G-Horizon/fpga-neural-style-camera/hardware/photos/single_board_product.jpg

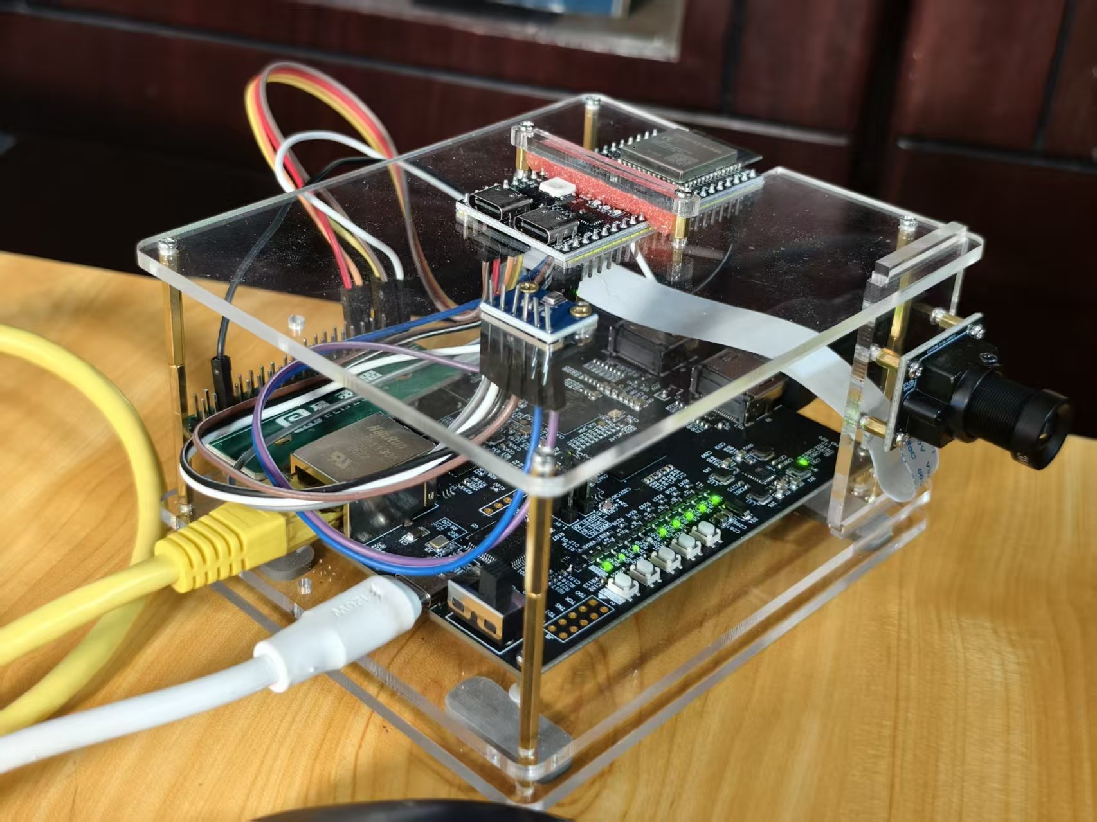
hardware/photos/single_board_product.jpg
