G-Horizon/fpga-neural-style-camera/docs/README.md

# 项目文档

本目录整理对外使用的系统说明与已测结果。

| 文档 | 内容 |
|---|---|
| [系统结构](system.md) | 单板与以太网双板链路、帧率含义、各板分工 |
| [模型与部署](model.md) | 模型结构、蒸馏、定点精度、共享计算、高清细节 |
| [使用与构建](build_and_use.md) | Efinity XML、ESP-IDF、手机网页与固件状态 |
| [接线说明](wiring.md) | 当前单板引脚、以太网双板连接、迁移外设的区别 |
| [手掌到握拳](gesture.md) | 空背景、动作规则、仿真与整机编译边界 |
| [性能与画质](performance/README.md) | 单板实测、双板已测项、量化效果 |
| [创新点与设计流程](design_process.md) | 从需求、训练、量化到硬件与集成验证 |
| [应用场景](applications.md) | 原型适用方向与实际落地条件 |
| [机械与加工资料](../hardware/README.md) | 自研亚克力平面图、参数、BOM与自有照片 |
