G-Horizon/fpga-neural-style-camera/models/teachers/README.md

# 三款教师权重

- vangogh_teacher.pth → student_d64_vangogh_affine
- ukiyoe_teacher.pth → student_d64_ukiyoe_affine
- inkwash_teacher.pth → student_d64_inkwash_affine
