G-Horizon/fpga-neural-style-camera/hardware/acrylic/dual_d2/hole_coordinates_mm.csv

part | hole | x_mm | y_mm | diameter_mm
DB01_Base | 1 | 5 | 5 | 2.4
DB01_Base | 2 | 5 | 95 | 2.4
DB01_Base | 3 | 115 | 95 | 2.4
DB01_Base | 4 | 115 | 15 | 2.4
DB02_Ti60_Carrier | 1 | 13 | 13 | 2.2
DB02_Ti60_Carrier | 2 | 13 | 48.814 | 2.2
DB02_Ti60_Carrier | 3 | 106.98 | 13 | 2.2
DB02_Ti60_Carrier | 4 | 106.98 | 87 | 2.2
DB02_Ti60_Carrier | 5 | 18.5 | 83 | 3.1
DB02_Ti60_Carrier | 6 | 48.5 | 83 | 3.1
DB02_Ti60_Carrier | 7 | 5 | 5 | 2.4
DB02_Ti60_Carrier | 8 | 5 | 95 | 2.4
DB02_Ti60_Carrier | 9 | 115 | 95 | 2.4
DB02_Ti60_Carrier | 10 | 115 | 15 | 2.4
DB02_Ti60_Carrier | 11 | 5 | 60 | 2.4
DB03_Optional_Top | 1 | 5 | 5 | 2.4
DB03_Optional_Top | 2 | 5 | 60 | 2.4
DB03_Optional_Top | 3 | 115 | 95 | 2.4
DB03_Optional_Top | 4 | 115 | 15 | 2.4
DB03_Optional_Top | 5 | 78 | 40 | 2.4
DB03_Optional_Top | 6 | 78 | 80 | 2.4
DB04_Optional_Camera | 1 | 4 | 22.5 | 2.2
DB04_Optional_Camera | 2 | 26 | 22.5 | 2.2
DB04_Optional_Camera | 3 | 4 | 37 | 2.2
DB04_Optional_Camera | 4 | 26 | 37 | 2.2
DB05_Optional_S3_Clamp | 1 | 0 | -20 | 2.4
DB05_Optional_S3_Clamp | 2 | 0 | 20 | 2.4
