G-Horizon/fpga-neural-style-camera/hardware/bom/dual_d4_30mm_mechanical_reference.csv

model_part_key | model_quantity | status_note
DB01_Base | 1 | D4 30mm complete CAD instance count; reference not actual purchased quantity
DB02_Ti60_Carrier | 2 | D4 30mm complete CAD instance count; reference not actual purchased quantity
FF_M2_L8_AF4 | 12 | D4 30mm complete CAD instance count; reference not actual purchased quantity
Nylon_M2_OD5_T0p5 | 98 | D4 30mm complete CAD instance count; reference not actual purchased quantity
Pan_M2x6 | 18 | D4 30mm complete CAD instance count; reference not actual purchased quantity
FF_M2_L30_D4 | 4 | D4 30mm complete CAD instance count; reference not actual purchased quantity
Stud_M2x12 | 7 | D4 30mm complete CAD instance count; reference not actual purchased quantity
Pan_M2x5 | 8 | D4 30mm complete CAD instance count; reference not actual purchased quantity
Foot_25x10x2_R2 | 4 | D4 30mm complete CAD instance count; reference not actual purchased quantity
FPGA_LIGHT | 2 | D4 30mm complete CAD instance count; reference not actual purchased quantity
DB04_Optional_Camera | 1 | D4 30mm complete CAD instance count; reference not actual purchased quantity
DB05_Optional_S3_Clamp | 1 | D4 30mm complete CAD instance count; reference not actual purchased quantity
S3 | 1 | D4 30mm complete CAD instance count; reference not actual purchased quantity
MIC | 1 | D4 30mm complete CAD instance count; reference not actual purchased quantity
Pan_M2x8 | 2 | D4 30mm complete CAD instance count; reference not actual purchased quantity
Nut_M2 | 8 | D4 30mm complete CAD instance count; reference not actual purchased quantity
Pan_M2x16 | 2 | D4 30mm complete CAD instance count; reference not actual purchased quantity
Silicone_pad_3x1p5_compressed2p4 | 1 | D4 30mm complete CAD instance count; reference not actual purchased quantity
Pan_M2x12 | 4 | D4 30mm complete CAD instance count; reference not actual purchased quantity
Nylon_camera_spacer_H3_OD4_ID2p2 | 4 | D4 30mm complete CAD instance count; reference not actual purchased quantity
DB03_Optional_Top | 1 | D4 30mm complete CAD instance count; reference not actual purchased quantity
FF_M2_L50_AF4 | 4 | D4 30mm complete CAD instance count; reference not actual purchased quantity
