G-Horizon/fpga-neural-style-camera/hardware/acrylic/dual_d2/DB04_Optional_Camera_1to1_mm.dxf

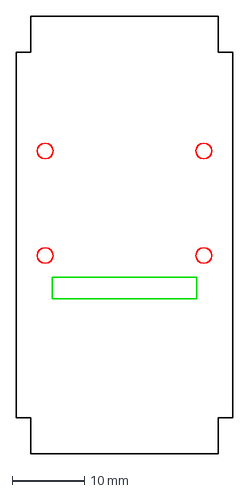
[picture p2: CAD file, 2026-11-03]
hardware/acrylic/dual_d2/DB04_Optional_Camera_1to1_mm.dxf
30.0 x 60.7 mm
