G-Horizon/fpga-neural-style-camera/hardware/acrylic/single_r2/02R2_camera_plate.dxf

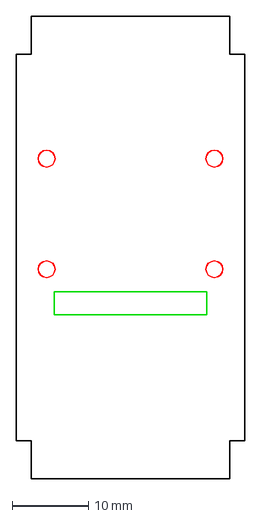
[picture p3: CAD file, 2026-11-03]
hardware/acrylic/single_r2/02R2_camera_plate.dxf
30.0 x 60.7 mm
