G-Horizon/fpga-neural-style-camera/hardware/acrylic/dual_d2/DB02_Ti60_Carrier_1to1_mm.dxf

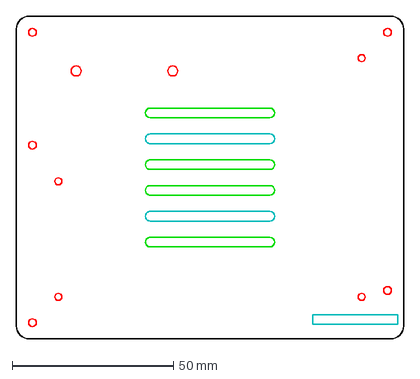
[picture p4: CAD file, 2026-11-03]
hardware/acrylic/dual_d2/DB02_Ti60_Carrier_1to1_mm.dxf
120.0 x 100.0 mm
