G-Horizon/fpga-neural-style-camera/hardware/acrylic/single_r2/05R2_s3_retainer.dxf

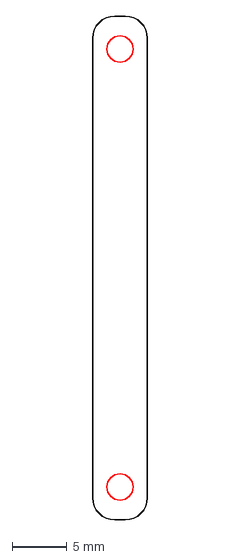
[picture p5: CAD file, 2026-11-03]
hardware/acrylic/single_r2/05R2_s3_retainer.dxf
5.00 x 46.0 mm
