G-Horizon/fpga-neural-style-camera/hardware/acrylic/dual_d2/DB05_Optional_S3_Clamp_1to1_mm.dxf

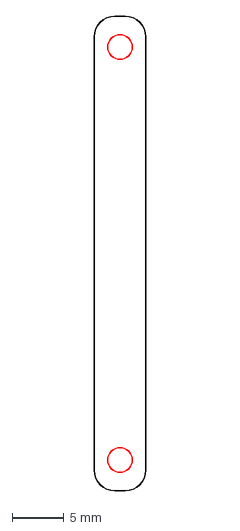
[picture p6: CAD file, 2026-11-03]
hardware/acrylic/dual_d2/DB05_Optional_S3_Clamp_1to1_mm.dxf
5.00 x 46.0 mm
