G-Horizon/fpga-neural-style-camera/hardware/acrylic/single_r2/01R2_mid_plate.dxf

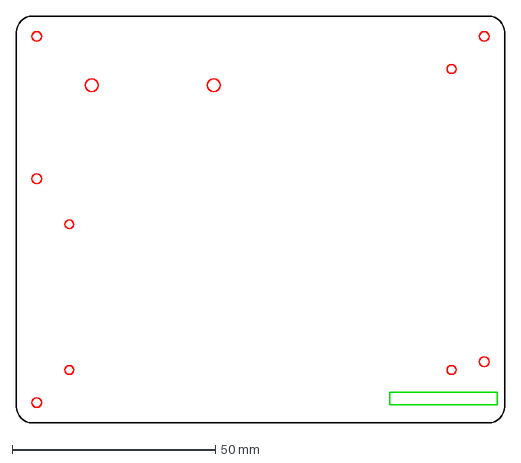
[picture p7: CAD file, 2026-11-03]
hardware/acrylic/single_r2/01R2_mid_plate.dxf
120.0 x 100.0 mm
