G-Horizon/fpga-neural-style-camera/hardware/acrylic/single_r2/04R2_upper_carrier.dxf

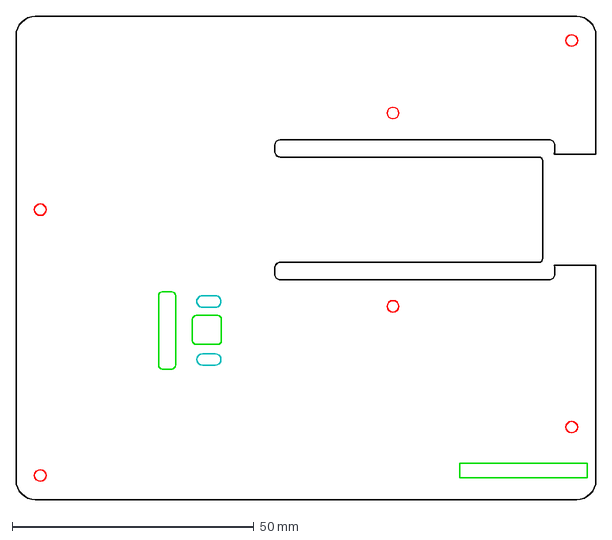
[picture p9: CAD file, 2026-11-03]
hardware/acrylic/single_r2/04R2_upper_carrier.dxf
120.0 x 100.0 mm
