G-Horizon/fpga-neural-style-camera/hardware/assembly_model/Ti60_Dual_Complete.SLDASM

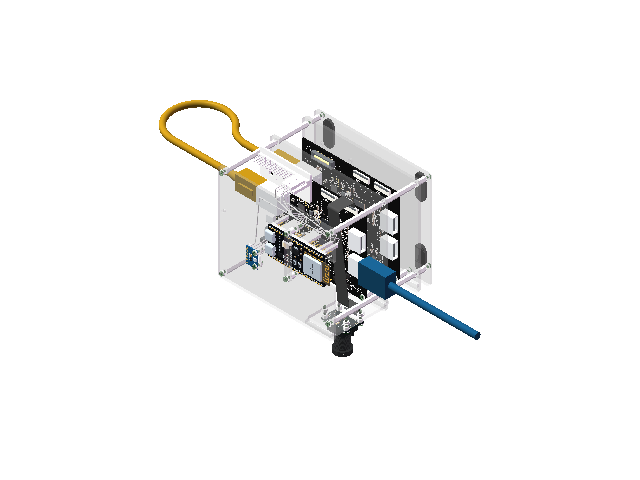
[picture p12: CAD file, 2026-11-03]
hardware/assembly_model/Ti60_Dual_Complete.SLDASM
DB01_Base_D2
DB02_Ti60_Carrier_D2 x 2
FF_M2_L8_AF4_D2 x 12
Nylon_M2_OD5_T0p5_D2 x 98
Pan_M2x6_D2 x 18
FF_M2_L30_D4 x 4
Stud_M2x12_D2 x 7
Pan_M2x5_D2 x 8
Adhesive_pad_25x10x2_R2 x 4
Ti60F225_holes_matched_to_measured_acrylic_R4_ASBUILT_R2 x 2
DB04_Optional_Camera_D2
DB05_Optional_S3_Clamp_D2
S3_R4_ASBUILT_R2
MIC_R4_ASBUILT_R2
Pan_M2x8_R4_ASBUILT_R2 x 2
Nut_M2_R4_ASBUILT_R2 x 8
Pan_M2x16_R4_ASBUILT_R2 x 2
Silicone_pad_3x1p5_compressed2p4_R4_ASBUILT_R2
Pan_M2x12_R4_ASBUILT_R2 x 4
Dupont_female_1x1_bored_R4_R4_ASBUILT_R2 x 18
Ribbon_signal_1_R5_ANIM_ASBUILT_R2
Ribbon_signal_2_R5_ANIM_ASBUILT_R2
Ribbon_signal_3_R5_ANIM_ASBUILT_R2
Ribbon_signal_4_R5_ANIM_ASBUILT_R2
Ribbon_signal_5_R5_ANIM_ASBUILT_R2
Mic_signal_1_R5_ANIM_ASBUILT_R2
Mic_signal_2_R5_ANIM_ASBUILT_R2
Mic_signal_3_R5_ANIM_ASBUILT_R2
Mic_signal_4_R5_ANIM_ASBUILT_R2
Common_GND_reference_R5_ANIM_ASBUILT_R2
Mic_3V3_reference_R5_ANIM_ASBUILT_R2
Mic_GND_reference_R5_ANIM_ASBUILT_R2
Camera_FPC_route_REFERENCE_R4_ASBUILT_R2
Camera_SC431HAI_6mm_PhotoReference_R4_ASBUILT_R2
Nylon_camera_spacer_H3_OD4_ID2p2_R4_ASBUILT_R2 x 4
EL001_J7_QTE_to_2x20_PhotoReference_R1_ASBUILT_R2
DB03_Optional_Top_D2
FF_M2_L50_AF4_D2 x 4
RJ45_Plug_Boot_REFERENCE_D3 x 2
Ethernet_Loop30_D4
HDMI_Display_Plug_REFERENCE_D3
HDMI_Display_Exit_OD6_L90_REFERENCE_D3
