G-Horizon/fpga-neural-style-camera/docs/build_and_use.md

# 使用与构建

### HDMI 显示

单板提供三种布局：

1. **全屏风格**：观看完整风格结果。
2. **并排对比**：左边完整原画、右边完整风格画，保持画面比例，上下留空。
3. **连续左右分屏**：左半显示原画对应位置，右半显示风格图对应位置，铺满 1920×1080，物体比例不变。

按风格键在梵高、浮世绘、水墨之间循环；另设帧率开关、布局切换和临时特效。具体键号、引脚和供电连接以所选工程配套接线说明为准。

三行数字分别表示：

| 屏幕文字 | 统计对象 |
|---|---|
| `CAM IN` | 合格的完整 256×144 摄像头输入帧成功入库速度，不仅统计帧起始信号 |
| `STYLE NEW` | 新风格结果进入显示的速度，重复显示旧帧不算新结果 |
| `HDMI SCAN` | HDMI 实际扫描刷新速度，单位 Hz |

### 手机观看与电脑遥控

ESP32-S3 使用 WROOM-1-N16R8 模组，通过 SPI 接收 FPGA 风格结果并建立本地热点，无需现场互联网或安装手机应用。

1. 按接线说明连接 FPGA、ESP32-S3 与麦克风，再给设备上电。
2. 手机或电脑连接演示热点 `Ti60-Style-Camera`，默认密码为 `ti60style`。
3. 手机 Chrome 打开 `http://192.168.4.1/`，竖屏观看白色主题页面。
4. 电脑打开 `http://192.168.4.1/debug`，进入遥控和状态页面。

手机接收 **256×144 风格图**，浏览器上采样为 **1280×720**。它没有再次运行 CNN，也没有采用 HDMI 端的原画细节融合，因此手机与 HDMI 的风格来源相同，但最终细节和接收帧率不同。

新单板KEY0轮换风格，KEY1开关三行帧率，KEY2切布局，KEY3触发特效。

### FPGA

1. 安装与工程对应的 **Efinity 2026.1**，准备 Ti60F225 板卡；
2. 各工程的 `profiles` 已包含配套三风格参数，保留原相对位置，并检查参数格式与所选固件版本匹配。
3. 单板在 Efinity 中打开 `final_camera_style.xml`；双板 A 打开 `d2e_board_a.xml`，双板 B 打开 **`d2e_board_b_full5.xml`**。它们位于对应方案的 `board/ddr3/` 目录。
4. 检查目标器件、引脚、时钟和模型文件引用，依次运行综合、布局布线、时序检查与 Bitstream 生成。
5. 通过 JTAG 下载 `.bit` 做临时运行。需要掉电保存时，使用配套 Flash 文件与烧录说明，同时写入所需模型区域。

`.bit` 编译通过、上板运行通过、Flash 写入通过和断电启动通过是不同的验收状态。

### ESP32-S3

白色页面固件使用 **ESP-IDF 6.0.1**。在已激活 ESP-IDF 环境的终端中，进入 `esp32/single/esp32/`：

```sh
idf.py -D SDKCONFIG=sdkconfig.mobile720-white menuconfig
idf.py -D SDKCONFIG=sdkconfig.mobile720-white build
idf.py -D SDKCONFIG=sdkconfig.mobile720-white -p PORT flash monitor
```

所附配置已选择 ESP32-S3。将 `PORT` 换成实际串口，在 `menuconfig` 中核对 16 MB Flash、DIO、80 MHz，以及热点、SPI、麦克风和语音选项。显式使用 `sdkconfig.mobile720-white`，并确认关闭 `STYLE_MOCK_SOURCE`：默认测试图不等于接收到真实 FPGA 画面。也可按 [ESP32 构建说明](../esp32/README.md)从仓库根目录使用配套构建脚本。

保留 `esp32/`、`mobile/`、`remote/` 的并列关系，构建会嵌入两套网页。只复制 ESP32 主程序而遗漏网页目录，会导致资源不完整。

### 重新训练模型

训练与定点导出属于离线步骤：准备内容与风格素材，训练教师，冻结教师训练学生，再折叠固定变换、校准和导出三套参数。具体环境、数据来源和命令以 `training/` 配套说明为准。改动网络通道、量化格式或参数布局后，需要同步调整 RTL 与整数参考，不能直接替换权重文件。

## 启动

- 当前单板正式固件为 `single_board_palm_to_fist.bit`。
