G-Horizon/fpga-neural-style-camera/docs/performance/README.md

# 已测性能与数值验证

## 1. 延迟结果

| 指标 | 单板 | 双板 |
|---|---|---|
| 整网推理延迟 | 平均 15.446 ms | - |
| 摄像头到屏幕可见响应 | 平均 100.9 ms | 平均 85.3 ms |
| 风格切换延迟 | 平均 47.750 ms | - |

光学延迟来自约 239.76 fps 录像，比较同一方格达到新旧亮度中点的时间，采样间隔约 4.171 ms；对应梵高风格、单板 30 帧和双板 60 帧的指定测试场景。切换延迟从控制器接受命令计时，到新风格首个有效像素进入显示链，不含按键去抖和液晶实际出光时间。

## 2. 单板实测三风格画质与量化误差

| 风格 | 每图PSNR平均 dB | 平均SSIM |
| --- | ---: | ---: |
| 梵高 | 37.8337 | 0.981044 |
| 浮世绘 | 43.3100 | 0.994728 |
| 水墨 | 44.3717 | 0.996078 |

## 单板方案编译指标

| 指标 | 编译结果 |
|---|---:|
| XLR | 60,711/60,800 |
| BRAM | 256/256 |
| DSP | 159/160 |
| setup余量 | +0.003ns |
| hold余量 | +0.010ns |
