G-Horizon/fpga-neural-style-camera/docs/performance/fixed24_integer_vs_fp32.csv

style | name | dataset | comparison | psnr_db | ssim_rgb | mae_levels | mse_levels2 | rmse_levels | max_abs_levels | exact_fraction | abs_gt1_fraction | p99_abs_levels
vangogh | val_000000477805 | fixed_val_16x9 | integer_vs_fp32_u8 | 41.375482139306456 | 0.9886611487192521 | 1.7287416811342593 | 4.73731372974537 | 2.1765370958808328 | 10.0 | 0.1943359375 | 0.5126862702546297 | 5.0
vangogh | val_000000122745 | fixed_val_16x9 | integer_vs_fp32_u8 | 42.01960712751918 | 0.987695183169683 | 1.5023781105324074 | 4.084318938078703 | 2.020969801377226 | 20.0 | 0.23069480613425927 | 0.41721824363425924 | 6.0
vangogh | val_000000289229 | fixed_val_16x9 | integer_vs_fp32_u8 | 32.109141572526866 | 0.9677555097161484 | 3.9995478877314814 | 40.00978370949074 | 6.325328743195151 | 55.0 | 0.13207103587962962 | 0.6459237557870371 | 24.0
vangogh | val_000000496409 | fixed_val_16x9 | integer_vs_fp32_u8 | 25.815082243098402 | 0.9309978561527475 | 8.311821831597221 | 170.44023980034723 | 13.055276320336818 | 113.0 | 0.07020399305555555 | 0.8035210503472222 | 49.0
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
