G-Horizon/fpga-neural-style-camera/fpga/single/board/ddr3/final_camera_style_top.v

`timescale 1ns/1ps
// Physical camera-only root. No simulated IP is in the hardware file list.
module final_camera_style_top #(
    // Staging default for the physically inverted camera. CFA3 is the
    // pure-reversal expectation; actual sensor colour phase remains to verify.
    parameter integer CAM_ROTATE_180=1,
    parameter [1:0] CAM_CFA=(CAM_ROTATE_180!=0 ? 2'd3 : 2'd0),
    parameter [15:0] CAM_WB_R_Q8=519,
    parameter [15:0] CAM_WB_G_Q8=256,
    parameter [15:0] CAM_WB_B_Q8=427,
    parameter integer CAM_GAMMA_EN=1,
    parameter integer DISPLAY_SCALE=5,
    parameter integer DISPLAY_BILINEAR=1, DISPLAY_DST_W=1920, DISPLAY_DST_H=1080,
    parameter integer CAM_PACKED=0, GUIDE_ENABLE=1, COMPACT_UART=1, STATUS_UART_ENABLE=0,
    parameter integer FPS_OSD_ENABLE=1, FPS_DEFAULT_ON=1,
    parameter integer VOICE_ENABLE=0,GESTURE_ENABLE=1,COMPARISON_ENABLE=1,PREVIEW_ENABLE=1,REMOTE_DEBUG_ENABLE=1
) (
    input wire clk_25m,
    input wire clk_weight_fast,
    input wire pll_lock,
    input wire pll1_lock,
    output wire ddr_pll_rstn,
    output wire sys_pll_rstn,
    input wire hdmi_tx_slow_clk,
    input wire hdmi_tx_fast_clk,
    input wire clk,
    input wire ddr_core_clk,
    input wire ddr_twd_clk,
    input wire ddr_tac_clk,
    input wire ddr_tdqss_clk,
    output wire ddr_reset,
    output wire ddr_cs,
    output wire ddr_ras,
    output wire ddr_cas,
    output wire ddr_we,
    output wire ddr_cke,
    output wire [15:0] ddr_addr,
    output wire [2:0] ddr_ba,
    output wire ddr_odt,
    output wire [1:0] o_ddr_dm_hi,
    output wire [1:0] o_ddr_dm_lo,
    input wire [1:0] i_ddr_dqs_hi,
    input wire [1:0] i_ddr_dqs_lo,
    input wire [1:0] i_ddr_dqs_n_hi,
    input wire [1:0] i_ddr_dqs_n_lo,
    output wire [1:0] o_ddr_dqs_hi,
    output wire [1:0] o_ddr_dqs_lo,
    output wire [1:0] o_ddr_dqs_oe,
    output wire [1:0] o_ddr_dqs_n_oe,
    input wire [15:0] i_ddr_dq_hi,
    input wire [15:0] i_ddr_dq_lo,
    output wire [15:0] o_ddr_dq_hi,
    output wire [15:0] o_ddr_dq_lo,
    output wire [15:0] o_ddr_dq_oe,
    output wire [2:0] ddr_shift,
    output wire [4:0] ddr_shift_sel,
    output wire ddr_shift_ena,
    input wire verf0,
    input wire verf1,
    output wire [9:0] tmds_data0_o,
    output wire [9:0] tmds_data1_o,
    output wire [9:0] tmds_data2_o,
    output wire [9:0] tmds_clk_o,
    output wire tmds_data0_TX_OE,
    output wire tmds_data1_TX_OE,
    output wire tmds_data2_TX_OE,
    output wire tmds_clk_TX_OE,
    output wire tmds_data0_TX_RST,
    output wire tmds_data1_TX_RST,
    output wire tmds_data2_TX_RST,
    output wire tmds_clk_TX_RST,
    output wire [3:0] led,
    output wire txd,
    output wire HPD_N,
    input wire [3:0] keys_n,
    input wire spi_preview_sclk,spi_preview_cs_n,spi_preview_mosi,
    output wire spi_preview_miso,spi_preview_ready,
    input wire [3:0] i_spi0_io,
    output wire [3:0] o_spi0_io,
    output wire [3:0] oe_spi0_io,
    output wire o_spi_clk,
    output wire oe_spi_clk,
    output wire o_spi0_cs,
    output wire oe_spi0_cs,
    input wire io_cam_scl_IN,
    input wire io_cam_sda_IN,
    input wire i_cam_ck_CLKOUT,
    input wire i_cam_ck_LP_N_IN,
    input wire i_cam_ck_LP_P_IN,
    input wire cam_d2_FIFO_EMPTY,
    input wire [7:0] cam_d2_HS_IN,
    input wire cam_d2_LP_N_IN,
    input wire cam_d2_LP_P_IN,
    input wire cam_d3_FIFO_EMPTY,
    input wire [7:0] cam_d3_HS_IN,
    input wire cam_d3_LP_N_IN,
    input wire cam_d3_LP_P_IN,
    input wire cam_d0_FIFO_EMPTY,
    input wire [7:0] cam_d0_HS_IN,
    input wire cam_d0_LP_N_IN,
    input wire cam_d0_LP_P_IN,
    input wire cam_d1_FIFO_EMPTY,
    input wire [7:0] cam_d1_HS_IN,
    input wire cam_d1_LP_N_IN,
    input wire cam_d1_LP_P_IN,
    output wire io_cam_scl_OUT,
    output wire io_cam_scl_OE,
    output wire io_cam_sda_OUT,
    output wire io_cam_sda_OE,
    output wire o_cam_rst_p,
    output wire o_cam_ck_HS_ENA,
    output wire o_cam_ck_HS_TERM,
    output wire cam_d2_FIFO_RD,
    output wire cam_d2_HS_ENA,
    output wire cam_d2_HS_TERM,
    output wire cam_d2_RST,
    output wire cam_d3_FIFO_RD,
    output wire cam_d3_HS_ENA,
    output wire cam_d3_HS_TERM,
    output wire cam_d3_RST,
    output wire cam_d0_FIFO_RD,
    output wire cam_d0_HS_ENA,
    output wire cam_d0_HS_TERM,
    output wire cam_d0_RST,
    output wire cam_d1_FIFO_RD,
    output wire cam_d1_HS_ENA,
    output wire cam_d1_HS_TERM,
    output wire cam_d1_RST,
    input wire sys_clk_50mhz,
    input wire hdmi_tx_locked
);
    wire camera_reset_n=pll_lock&&pll1_lock;
    wire camera_accepting;
    wire rx_pix_valid_o;
    wire [63:0] rx_pix_data_o;
    wire [3:0] rx_pix_per_clk_o;
    wire rx_hsync_o;
    wire rx_vsync_o;
    wire rst_pix_n_o;
    wire config_done;
    wire config_error;
    wire [31:0] sensor_readback;
    wire [7:0] sensor_orientation_readback; // optional future UART observation
    wire [5:0] rx_datatype_o;
    wire rx_irq_o;
    wire [15:0] rx_word_count_o;
    wire [15:0] rx_shortpkt_o;
    wire [1:0] rx_vc_o;
    wire raw_valid,raw_sof,raw_sol,raw_eol,raw_eof;
    wire[9:0] raw10;wire[31:0] raw_frame_id;
    wire raw_overflow,raw_ppc_bad;
    wire packed_valid,packed_sof,packed_sol,packed_eol,packed_eof;
    wire [39:0] packed_raw4;
    wire [31:0] packed_fid;
    wire packed_bad;
    d64_camera_frontend_517 #(.ROTATE_180(CAM_ROTATE_180)) u_camera(
        .i_arstn(camera_reset_n),
        .CLK_25M(clk_25m),
        .core_clk(clk),
        .i_mipi_rx_pclk(sys_clk_50mhz),
        .io_cam_scl_IN(io_cam_scl_IN),
        .io_cam_sda_IN(io_cam_sda_IN),
        .i_cam_ck_CLKOUT(i_cam_ck_CLKOUT),
        .i_cam_ck_LP_N_IN(i_cam_ck_LP_N_IN),
        .i_cam_ck_LP_P_IN(i_cam_ck_LP_P_IN),
        .cam_d2_FIFO_EMPTY(cam_d2_FIFO_EMPTY),
        .cam_d2_HS_IN(cam_d2_HS_IN),
        .cam_d2_LP_N_IN(cam_d2_LP_N_IN),
        .cam_d2_LP_P_IN(cam_d2_LP_P_IN),
        .cam_d3_FIFO_EMPTY(cam_d3_FIFO_EMPTY),
        .cam_d3_HS_IN(cam_d3_HS_IN),
        .cam_d3_LP_N_IN(cam_d3_LP_N_IN),
        .cam_d3_LP_P_IN(cam_d3_LP_P_IN),
        .cam_d0_FIFO_EMPTY(cam_d0_FIFO_EMPTY),
        .cam_d0_HS_IN(cam_d0_HS_IN),
        .cam_d0_LP_N_IN(cam_d0_LP_N_IN),
        .cam_d0_LP_P_IN(cam_d0_LP_P_IN),
        .cam_d1_FIFO_EMPTY(cam_d1_FIFO_EMPTY),
        .cam_d1_HS_IN(cam_d1_HS_IN),
        .cam_d1_LP_N_IN(cam_d1_LP_N_IN),
        .cam_d1_LP_P_IN(cam_d1_LP_P_IN),
        .io_cam_scl_OUT(io_cam_scl_OUT),
        .io_cam_scl_OE(io_cam_scl_OE),
        .io_cam_sda_OUT(io_cam_sda_OUT),
        .io_cam_sda_OE(io_cam_sda_OE),
        .o_cam_rst_p(o_cam_rst_p),
        .o_cam_ck_HS_ENA(o_cam_ck_HS_ENA),
        .o_cam_ck_HS_TERM(o_cam_ck_HS_TERM),
        .cam_d2_FIFO_RD(cam_d2_FIFO_RD),
        .cam_d2_HS_ENA(cam_d2_HS_ENA),
        .cam_d2_HS_TERM(cam_d2_HS_TERM),
        .cam_d2_RST(cam_d2_RST),
        .cam_d3_FIFO_RD(cam_d3_FIFO_RD),
        .cam_d3_HS_ENA(cam_d3_HS_ENA),
        .cam_d3_HS_TERM(cam_d3_HS_TERM),
        .cam_d3_RST(cam_d3_RST),
        .cam_d0_FIFO_RD(cam_d0_FIFO_RD),
        .cam_d0_HS_ENA(cam_d0_HS_ENA),
        .cam_d0_HS_TERM(cam_d0_HS_TERM),
        .cam_d0_RST(cam_d0_RST),
        .cam_d1_FIFO_RD(cam_d1_FIFO_RD),
        .cam_d1_HS_ENA(cam_d1_HS_ENA),
        .cam_d1_HS_TERM(cam_d1_HS_TERM),
        .cam_d1_RST(cam_d1_RST),
        .rx_pix_valid_o(rx_pix_valid_o),
        .rx_pix_data_o(rx_pix_data_o),
        .rx_pix_per_clk_o(rx_pix_per_clk_o),
        .rx_hsync_o(rx_hsync_o),
        .rx_vsync_o(rx_vsync_o),
        .rst_pix_n_o(rst_pix_n_o),
        .config_done(config_done),
        .config_error(config_error),
        .sensor_readback(sensor_readback),
        .sensor_orientation_readback(sensor_orientation_readback),
        .rx_datatype_o(rx_datatype_o),
        .rx_irq_o(rx_irq_o),
        .rx_word_count_o(rx_word_count_o),
        .rx_shortpkt_o(rx_shortpkt_o),
        .rx_vc_o(rx_vc_o)
    );
    generate if(CAM_PACKED==0)begin:g_scalar_raw
    assign packed_valid=0;assign packed_raw4=0;assign packed_sof=0;
    assign packed_sol=0;assign packed_eol=0;assign packed_eof=0;assign packed_fid=0;assign packed_bad=0;
    d64_csi2_raw_to_contract_a #(.AW(9),.PPC_MAX(4),.W_SRC(1920),.H_SRC(1080)) u_raw(
        .clk_pix(sys_clk_50mhz),
        .rst_pix_n(rst_pix_n_o),
        .pix_valid(rx_pix_valid_o),
        .pix_data(rx_pix_data_o),
        .pix_per_clk(rx_pix_per_clk_o),
        .hsync(rx_hsync_o),
        .vsync(rx_vsync_o),
        .clk_a(clk),
        .rst_a_n(camera_reset_n),
        .raw_valid(raw_valid),
        .raw10(raw10),
        .raw_sof(raw_sof),
        .raw_sol(raw_sol),
        .raw_eol(raw_eol),
        .raw_eof(raw_eof),
        .raw_frame_id(raw_frame_id),
        .beats_in(),
        .px_in(),
        .beats_out(),
        .px_out(),
        .frames_out(),
        .overflow(raw_overflow),
        .ppc_bad(raw_ppc_bad)
    );
    end else begin:g_packed_raw
        wire native_bad;
        assign raw_valid=0;assign raw10=0;assign raw_sof=0;assign raw_sol=0;
        assign raw_eol=0;assign raw_eof=0;assign raw_frame_id=0;
        (* async_reg="true" *) reg [1:0] packed_bad_sync;
        always @(posedge clk or negedge camera_reset_n)
            if(!camera_reset_n)packed_bad_sync<=0;
            else packed_bad_sync<={packed_bad_sync[0],native_bad};
        assign raw_overflow=packed_bad_sync[1];assign raw_ppc_bad=packed_bad_sync[1];
        assign packed_bad=native_bad;
        d64_packed_raw_camera_adapter u_adapter(
            .clk_pix(sys_clk_50mhz),.rst_pix_n(rst_pix_n_o),
            .pix_valid(rx_pix_valid_o),.pix_data(rx_pix_data_o),.pix_per_clk(rx_pix_per_clk_o),
            .vsync(rx_vsync_o),.raw_valid(packed_valid),.raw4(packed_raw4),
            .raw_sof(packed_sof),.raw_sol(packed_sol),.raw_eol(packed_eol),.raw_eof(packed_eof),
            .raw_frame_id(packed_fid),.beats_in(),.packing_errors(),.incomplete_frames(),
            .source_bad_sticky(native_bad));
    end endgenerate
    (* async_reg="true" *) reg [1:0] capture_allow_pix;
    reg packed_capture_enabled;
    always @(posedge sys_clk_50mhz or negedge rst_pix_n_o)begin
        if(!rst_pix_n_o)begin capture_allow_pix<=0;packed_capture_enabled<=0;end
        else begin
            capture_allow_pix<={capture_allow_pix[0],config_done&&!config_error&&camera_accepting};
            if(packed_valid&&packed_sof&&capture_allow_pix[1])packed_capture_enabled<=1;
        end
    end
    reg capture_enabled=0;
    always @(posedge clk or negedge camera_reset_n) begin
        if(!camera_reset_n)capture_enabled<=0;
        else if(raw_sof&&config_done&&!config_error&&camera_accepting)capture_enabled<=1;
    end
    d64_final_system #(.CAM_CFA(CAM_CFA),
        .CAM_PACKED(CAM_PACKED),.GUIDE_ENABLE(GUIDE_ENABLE),.COMPACT_UART(COMPACT_UART),
        .CAM_WB_R_Q8(CAM_WB_R_Q8), .CAM_WB_G_Q8(CAM_WB_G_Q8),
        .CAM_WB_B_Q8(CAM_WB_B_Q8), .CAM_GAMMA_EN(CAM_GAMMA_EN),.DISPLAY_SCALE(DISPLAY_SCALE),
        .DISPLAY_BILINEAR(DISPLAY_BILINEAR),.DISPLAY_DST_W(DISPLAY_DST_W),.DISPLAY_DST_H(DISPLAY_DST_H),
        .H_ACT(1920),.H_FP(88),.H_SYNC(44),.H_BP(148),
        .V_ACT(1080),.V_FP(4),.V_SYNC(5),.V_BP(36),
        .FPS_OSD_ENABLE(FPS_OSD_ENABLE),.FPS_DEFAULT_ON(FPS_DEFAULT_ON),
        .STATUS_UART_ENABLE(STATUS_UART_ENABLE),.VOICE_ENABLE(VOICE_ENABLE),.GESTURE_ENABLE(GESTURE_ENABLE),.COMPARISON_ENABLE(COMPARISON_ENABLE),.PREVIEW_ENABLE(PREVIEW_ENABLE),.REMOTE_DEBUG_ENABLE(REMOTE_DEBUG_ENABLE)) u_system(
        .clk_25m(clk_25m),
        .pll_lock(pll_lock),
        .pll1_lock(pll1_lock),
        .pe_pll_lock(hdmi_tx_locked),
        .ddr_pll_rstn(ddr_pll_rstn),
        .sys_pll_rstn(sys_pll_rstn),
        .pe_pll_rstn(),
        .clk_pe(clk),
        .clk_weight_fast(clk_weight_fast),
        .hdmi_tx_slow_clk(hdmi_tx_slow_clk),
        .hdmi_tx_fast_clk(hdmi_tx_fast_clk),
        .clk(clk),
        .ddr_core_clk(ddr_core_clk),
        .ddr_twd_clk(ddr_twd_clk),
        .ddr_tac_clk(ddr_tac_clk),
        .ddr_tdqss_clk(ddr_tdqss_clk),
        .ddr_reset(ddr_reset),
        .ddr_cs(ddr_cs),
        .ddr_ras(ddr_ras),
        .ddr_cas(ddr_cas),
        .ddr_we(ddr_we),
        .ddr_cke(ddr_cke),
        .ddr_addr(ddr_addr),
        .ddr_ba(ddr_ba),
        .ddr_odt(ddr_odt),
        .o_ddr_dm_hi(o_ddr_dm_hi),
        .o_ddr_dm_lo(o_ddr_dm_lo),
        .i_ddr_dqs_hi(i_ddr_dqs_hi),
        .i_ddr_dqs_lo(i_ddr_dqs_lo),
        .i_ddr_dqs_n_hi(i_ddr_dqs_n_hi),
        .i_ddr_dqs_n_lo(i_ddr_dqs_n_lo),
        .o_ddr_dqs_hi(o_ddr_dqs_hi),
        .o_ddr_dqs_lo(o_ddr_dqs_lo),
        .o_ddr_dqs_n_hi(),
        .o_ddr_dqs_n_lo(),
        .o_ddr_dqs_oe(o_ddr_dqs_oe),
        .o_ddr_dqs_n_oe(o_ddr_dqs_n_oe),
        .i_ddr_dq_hi(i_ddr_dq_hi),
        .i_ddr_dq_lo(i_ddr_dq_lo),
        .o_ddr_dq_hi(o_ddr_dq_hi),
        .o_ddr_dq_lo(o_ddr_dq_lo),
        .o_ddr_dq_oe(o_ddr_dq_oe),
        .ddr_shift(ddr_shift),
        .ddr_shift_sel(ddr_shift_sel),
        .ddr_shift_ena(ddr_shift_ena),
        .verf0(verf0),
        .verf1(verf1),
        .cam_raw_valid(raw_valid&&(capture_enabled||raw_sof)&&config_done&&!config_error&&camera_accepting),
        .cam_raw10(raw10),
        .cam_sof(raw_sof),
        .cam_sol(raw_sol),
        .cam_eol(raw_eol),
        .cam_eof(raw_eof),
        .cam_frame_id(raw_frame_id),
        .cam_packed_clk(sys_clk_50mhz),.cam_packed_rst_n(rst_pix_n_o),
        .cam_packed_valid(packed_valid&&(packed_capture_enabled||packed_sof)&&capture_allow_pix[1]),
        .cam_packed_raw4(packed_raw4),.cam_packed_sof(packed_sof),.cam_packed_sol(packed_sol),
        .cam_packed_eol(packed_eol),.cam_packed_eof(packed_eof),.cam_packed_fid(packed_fid),
        .cam_packed_source_bad(packed_bad),
        .io_cam_scl_IN(1'b1),
        .io_cam_sda_IN(1'b1),
        .io_cam_scl_OUT(),
        .io_cam_scl_OE(),
        .io_cam_sda_OUT(),
        .io_cam_sda_OE(),
        .o_cam_rst_p(),
        .tmds_data0_o(tmds_data0_o),
        .tmds_data1_o(tmds_data1_o),
        .tmds_data2_o(tmds_data2_o),
        .tmds_clk_o(tmds_clk_o),
        .tmds_data0_TX_OE(tmds_data0_TX_OE),
        .tmds_data1_TX_OE(tmds_data1_TX_OE),
        .tmds_data2_TX_OE(tmds_data2_TX_OE),
        .tmds_clk_TX_OE(tmds_clk_TX_OE),
        .tmds_data0_TX_RST(tmds_data0_TX_RST),
        .tmds_data1_TX_RST(tmds_data1_TX_RST),
        .tmds_data2_TX_RST(tmds_data2_TX_RST),
        .tmds_clk_TX_RST(tmds_clk_TX_RST),
        .led(led),
        .txd(txd),
        .HPD_N(HPD_N),
        .keys_n(keys_n),
        .spi_preview_sclk(spi_preview_sclk),.spi_preview_cs_n(spi_preview_cs_n),.spi_preview_mosi(spi_preview_mosi),
        .spi_preview_miso(spi_preview_miso),.spi_preview_ready(spi_preview_ready),
        .camera_status({3'd0,rx_word_count_o,rx_vc_o,rx_datatype_o,rx_irq_o,raw_ppc_bad,raw_overflow,config_error,config_done}),
        .camera_readback(sensor_readback),
        .camera_accepting(camera_accepting),
        .i_spi0_io(i_spi0_io),
        .o_spi0_io(o_spi0_io),
        .oe_spi0_io(oe_spi0_io),
        .o_spi_clk(o_spi_clk),
        .oe_spi_clk(oe_spi_clk),
        .o_spi0_cs(o_spi0_cs),
        .oe_spi0_cs(oe_spi0_cs)
    );
endmodule
