G-Horizon/fpga-neural-style-camera/fpga/dual/board_a/rtl/d2e_a_slots_fast3.v

`timescale 1ns/1ps
// Eight native guides stay leased from camera commit through remote compute
// and display retirement. All ports below belong to the application clock.
module d2e_a_slots(
 input wire clk,rst_n,session_valid,input wire[31:0]local_session,remote_session,
 input wire capture_commit,input wire[2:0]capture_slot,input wire[31:0]capture_fid,
 output reg release_valid,output reg[2:0]release_slot,output wire[7:0]owned_mask,
 input wire[1:0]ui_style,input wire ui_fps,input wire[7:0]ui_effect,input wire[31:0]ui_epoch,
 input wire compute_ready,compute_done,compute_fault,output reg compute_start,
 output reg[2:0]compute_slot,output wire[1:0]compute_profile,output wire[31:0]compute_fid,
 output wire tx_job_valid,input wire tx_job_ready,output wire[31:0]tx_base,tx_fid,tx_epoch,
 output wire[1:0]tx_style,tx_layout,output wire tx_fps,output wire[7:0]tx_effect,
 input wire tx_done,tx_done_ok,input wire[31:0]tx_done_fid,
 input wire allocate_valid,output wire allocate_ready,allocate_ok,output wire[31:0]allocate_base,
 input wire[31:0]allocate_fid,allocate_epoch,input wire[1:0]allocate_style,allocate_layout,
 input wire allocate_fps,input wire[7:0]allocate_effect,
 input wire commit_valid,commit_cancel,output wire commit_ready,
 input wire[31:0]commit_base,commit_fid,commit_epoch,input wire[1:0]commit_style,commit_layout,
 input wire commit_fps,input wire[7:0]commit_effect,
 input wire abort_valid,input wire[31:0]abort_base,abort_fid,
 output reg publish_valid,input wire publish_ready,output wire[31:0]publish_base,publish_fid,publish_epoch,
 output wire[2:0]publish_slot,output wire publish_fps,
 input wire active_valid,input wire[31:0]active_fid,active_epoch,active_base,
 input wire[7:0]reader_protect_mask,
 output reg fault,output reg[31:0]computed_frames,returned_frames,published_frames,retired_frames,discarded_frames
);
 localparam FREE=0,CAPTURED=1,COMPUTING=2,COMPUTED=3,WAITING=4,RESULT=5,PENDING=6,DISPLAY=7,RETIRING=8;
 reg[3:0]state[0:7];reg[31:0]fid[0:7],epoch[0:7];
 reg[1:0]style[0:7];reg fps[0:7];reg[7:0]effect[0:7];
 reg[7:0]stale,rx_lease,feature_acked;reg[3:0]retire_guard[0:7];
 reg compute_busy,tx_busy,publish_busy,tx_offer_valid;reg[2:0]tx_slot,pub_slot;
 reg previous_session_valid;reg[31:0]previous_local,previous_remote;
 wire session_change=previous_session_valid&&(!session_valid||local_session!=previous_local||remote_session!=previous_remote);
 wire session_current=session_valid&&!session_change;
 // Unaccepted jobs are cancellable at a session boundary. Mask the offer in
 // that same cycle so a ready receiver cannot accept the old-session job.
 // Within one session valid and all metadata remain held until acceptance.
 assign tx_job_valid=tx_offer_valid&&session_current;
 function[31:0]result_address;input[2:0]s;begin result_address=32'h03000000+{11'd0,s,18'd0};end endfunction
 function[31:0]tensor_address;input[2:0]s;begin tensor_address=32'h01300000+{7'd0,s,22'd0};end endfunction
 function valid_result_address;input[31:0]b;begin valid_result_address=(b&32'hffe3ffff)==32'h03000000;end endfunction
 assign compute_profile=compute_busy?style[compute_slot]+2'd1:ui_style;
 assign compute_fid=fid[compute_slot];
 assign tx_base=tensor_address(tx_slot);assign tx_fid=fid[tx_slot];assign tx_epoch=epoch[tx_slot];
 assign tx_style=style[tx_slot];assign tx_layout=0;assign tx_fps=fps[tx_slot];assign tx_effect=effect[tx_slot];
 assign publish_slot=pub_slot;assign publish_base=result_address(pub_slot);assign publish_fid=fid[pub_slot];
 assign publish_epoch=epoch[pub_slot];assign publish_fps=fps[pub_slot];
 genvar g;generate for(g=0;g<8;g=g+1)begin:o assign owned_mask[g]=state[g]!=FREE;end endgenerate
 integer i,j;reg free_found,alloc_found,capture_duplicate;
 reg[2:0]free_pick,alloc_pick;
 wire cap_found,tx_found,pub_found;wire[2:0]cap_pick,tx_pick,pub_pick;
 wire[7:0]cap_eligible,tx_eligible,pub_eligible;wire[599:0]pick_metadata;
 wire[74:0]pick_word[0:7];reg[2:0]pick_index;wire[74:0]pick_current_meta=pick_word[pick_index];
 generate for(g=0;g<8;g=g+1)begin:pick_inputs
  assign cap_eligible[g]=state[g]==CAPTURED&&!stale[g];
  assign tx_eligible[g]=state[g]==COMPUTED&&!stale[g];
  assign pub_eligible[g]=state[g]==RESULT&&feature_acked[g]&&!stale[g];
  assign pick_word[g]={effect[g],fps[g],style[g],epoch[g],fid[g]};
  assign pick_metadata[g*75+:75]=pick_word[g];
 end endgenerate
 wire pick_restart=capture_commit||compute_done||tx_done||commit_valid||session_change;
 always @(posedge clk or negedge rst_n)
  if(!rst_n)pick_index<=0;
  else if(!session_current||pick_restart)pick_index<=0;
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
